NikkiOfTheValley/lumacpu/README.md

# lumacpu
LumaCPU is a custom SBC created for fun/learning
