NikkiOfTheValley/lumacpu/luma_cpu_v4.kicad_pcb

## KiCad design luma_cpu_v4.kicad_pcb (2024-12-23)

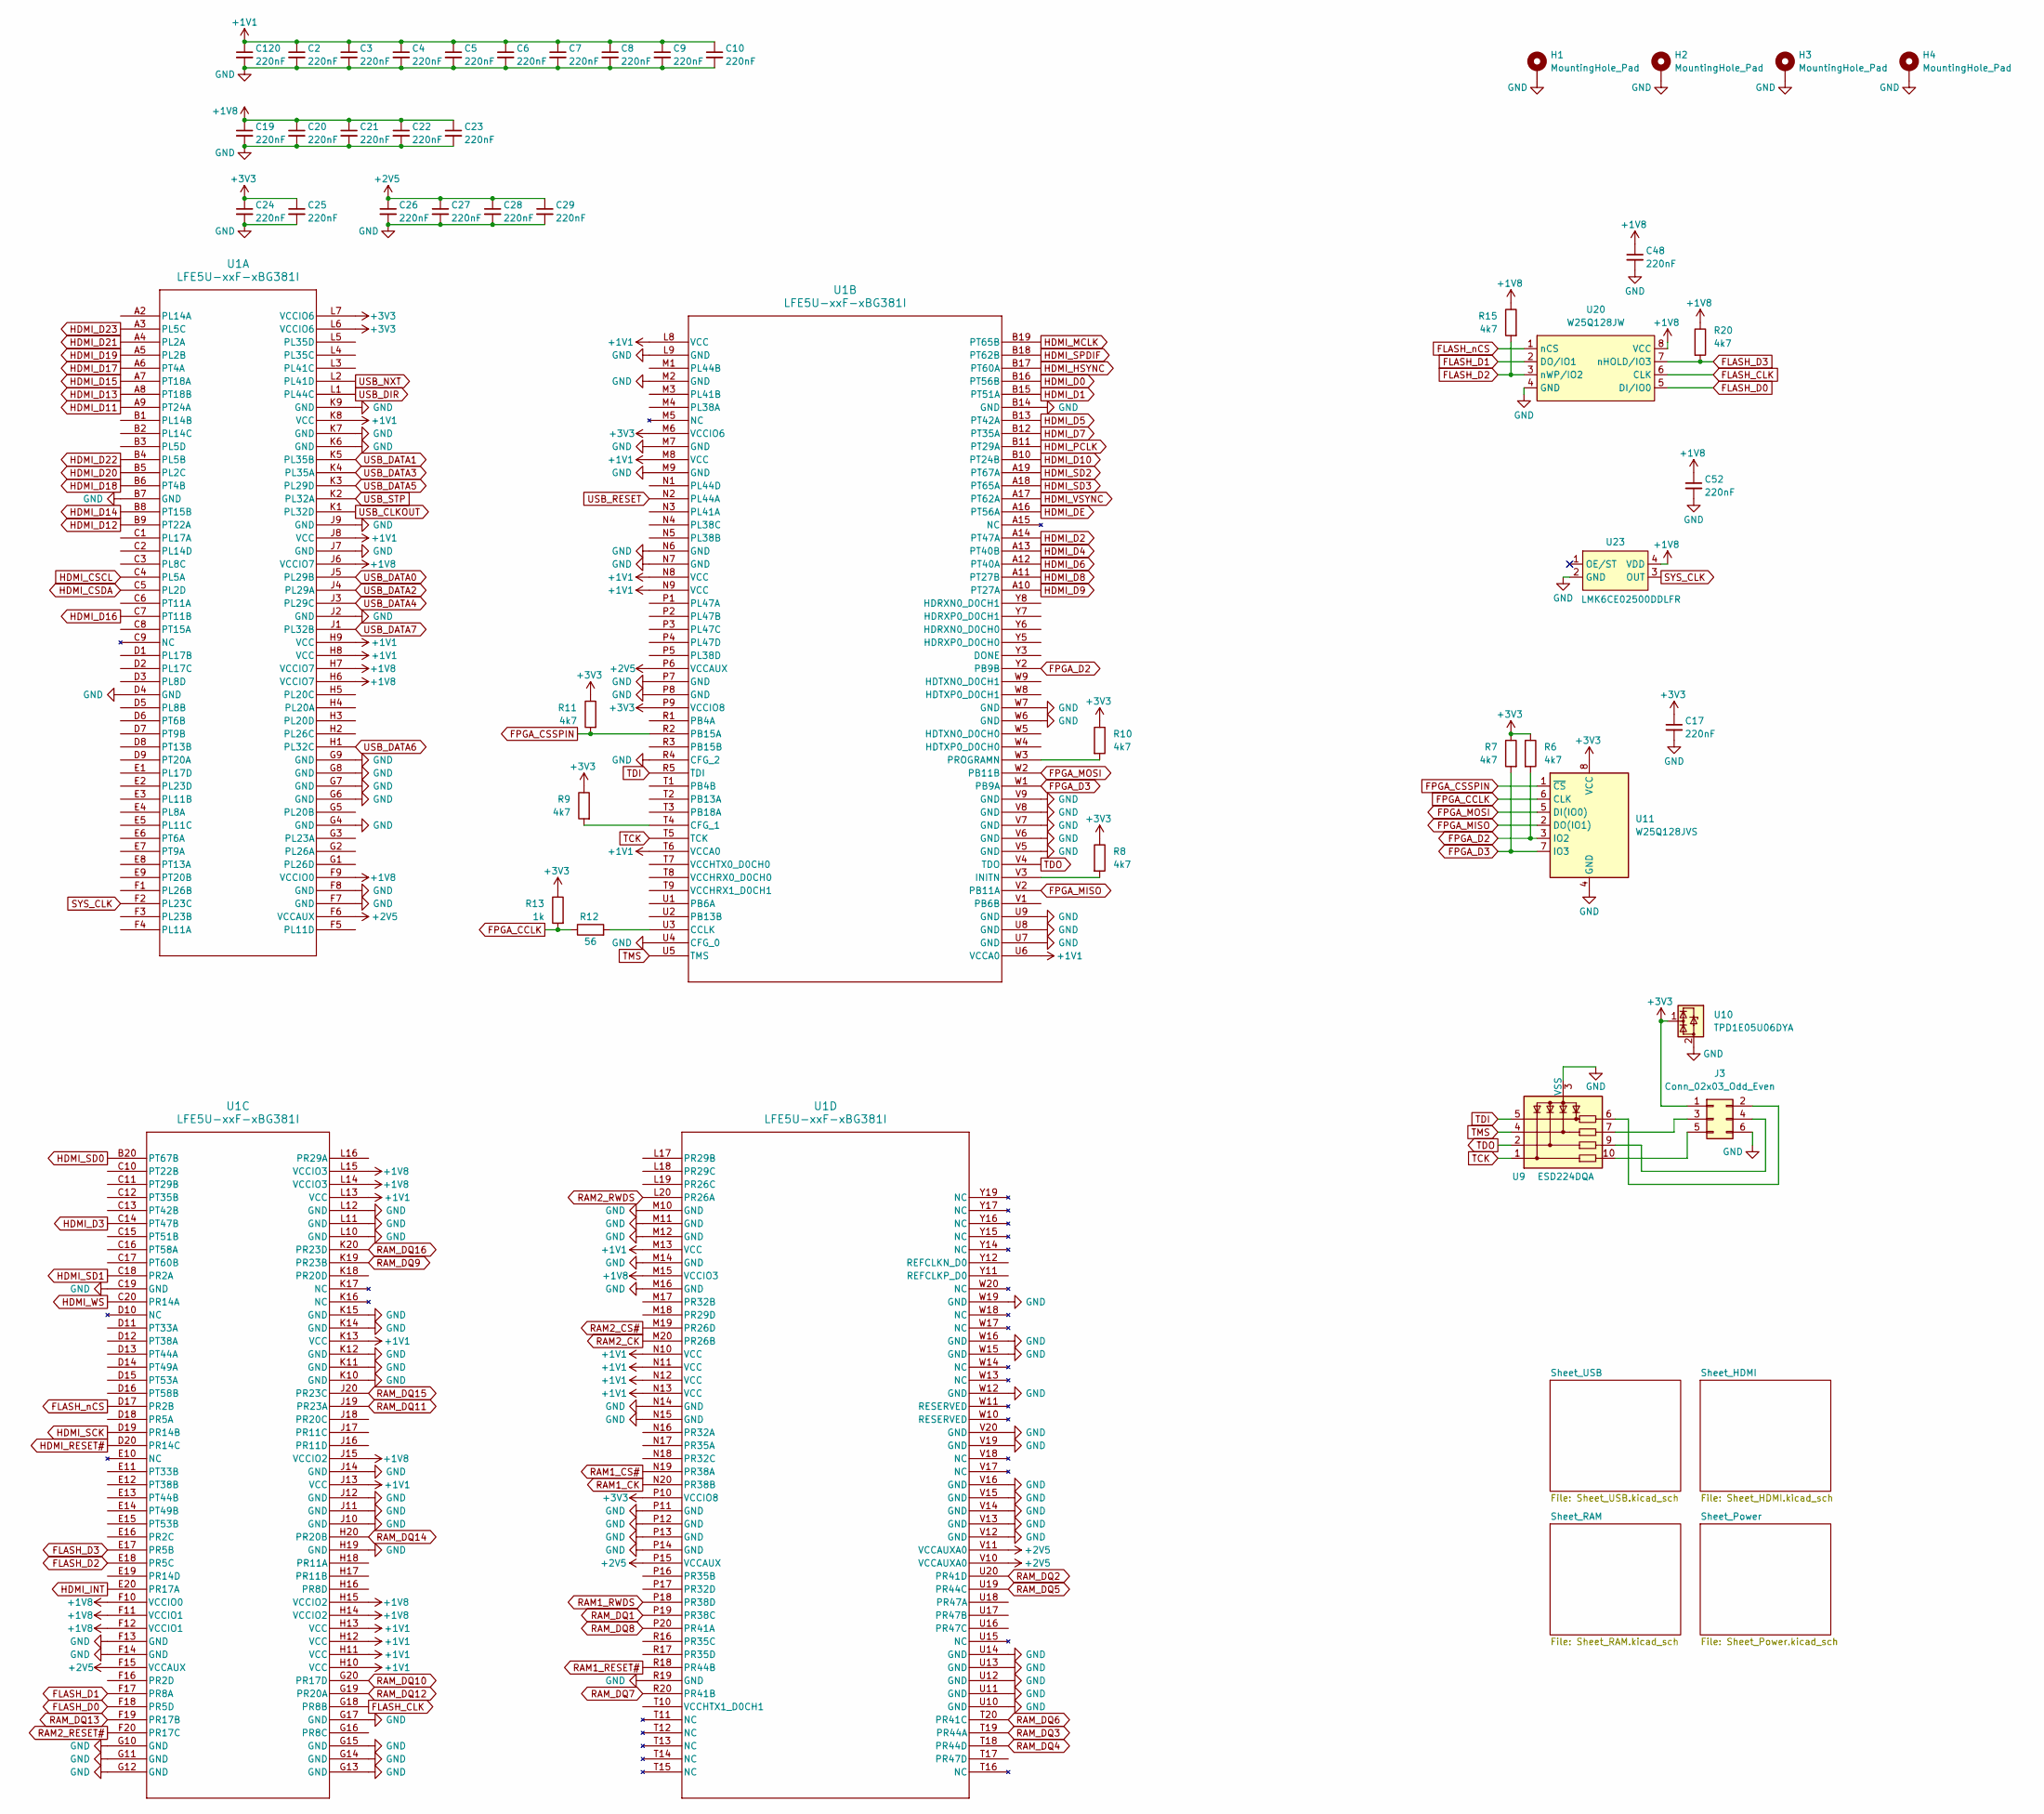
[picture p1: schematic Sheet_FPGA.kicad_sch]

Parts:
C2, C3, C4, C5, C6, C7, C8, C9, C10, C17, C19, C20, C21, C22, C23, C24, C25, C26, C27, C28, C29, C48, C52, C120: 220nF; C_0201_0603Metric_Pad0.64x0.40mm_HandSolder
H1, H2, H3, H4: MountingHole_Pad; MountingHole_1.2mm_M1_Pad
J3: Conn_02x03_Odd_Even; PinHeader_2x03_P2.54mm_Vertical
R6, R7, R8, R9, R10, R11, R15, R20: 4k7; R_0402_1005Metric_Pad0.72x0.64mm_HandSolder
R12: 56; R_0402_1005Metric_Pad0.72x0.64mm_HandSolder
R13: 1k; R_0402_1005Metric_Pad0.72x0.64mm_HandSolder
U1: LFE5U-xxF-xBG381I; CABGA381_LAT
U9: ESD224DQA; Diodes_UDFN-10_1.0x2.5mm_P0.5mm
U10: TPD1E05U06DYA; D_SOD-523
U11: W25Q128JVS; SOIC-8_5.23x5.23mm_P1.27mm
U20: W25Q128JW; SOIC-8W_5.3x5.3mm_P1.27mm
U23: LMK6CE02500DDLFR; VSON-4_2.5x2mm_P1.5mm

Connections:
+1V1: C2.1, C3.1, C4.1, C5.1, C6.1, C7.1, C8.1, C9.1, C10.1, U1.H8 (VCC), U1.H9 (VCC), U1.H10 (VCC), U1.H11 (VCC), U1.H12 (VCC), U1.H13 (VCC), U1.J8 (VCC), U1.J13 (VCC), U1.K8 (VCC), U1.K13 (VCC), U1.L8 (VCC), U1.L13 (VCC), U1.M8 (VCC), U1.M13 (VCC), U1.N8 (VCC), U1.N9 (VCC), U1.N10 (VCC), U1.N11 (VCC), U1.N12 (VCC), U1.N13 (VCC), U1.T6 (VCCA0), U1.U6 (VCCA0); also elsewhere on the board
+1V8: C19.1, C20.1, C21.1, C22.1, C23.1, C48.1, C52.1, R15.1, R20.1, U1.F9 (VCCIO0), U1.F10 (VCCIO0), U1.F11 (VCCIO1), U1.F12 (VCCIO1), U1.H6 (VCCIO7), U1.H7 (VCCIO7), U1.H14 (VCCIO2), U1.H15 (VCCIO2), U1.J6 (VCCIO7), U1.J15 (VCCIO2), U1.L14 (VCCIO3), U1.L15 (VCCIO3), U1.M15 (VCCIO3), U20.8 (VCC), U23.4 (VDD); also elsewhere on the board
+2V5: C26.1, C27.1, C28.1, C29.1, U1.F6 (VCCAUX), U1.F15 (VCCAUX), U1.P6 (VCCAUX), U1.P15 (VCCAUX), U1.V10 (VCCAUXA0), U1.V11 (VCCAUXA0); also elsewhere on the board
+3V3: C17.1, C24.1, C25.1, J3.1, R6.1, R7.1, R8.1, R9.1, R10.1, R11.1, R13.1, U1.L6 (VCCIO6), U1.L7 (VCCIO6), U1.M6 (VCCIO6), U1.P9 (VCCIO8), U1.P10 (VCCIO8), U10.1 (I/O), U11.8 (VCC); also elsewhere on the board
FLASH_CLK: U1.G18 (PR8B), U20.6 (CLK)
FLASH_D0: U1.F18 (PR5D), U20.5 (DI/IO0)
FLASH_D1: U1.F17 (PR8A), U20.2 (DO/IO1)
FLASH_D2: R15.2, U1.E18 (PR5C), U20.3 (nWP/IO2)
FLASH_D3: R20.2, U1.E17 (PR5B), U20.7 (nHOLD/IO3)
FLASH_nCS: U1.D17 (PR2B), U20.1 (nCS)
FPGA_CCLK: R12.1, R13.2, U11.6 (CLK)
FPGA_CSSPIN: R11.2, U1.R2 (PB15A), U11.1 (~CS)
FPGA_D2: R6.2, U1.Y2 (PB9B), U11.3 (IO2)
FPGA_D3: R7.2, U1.W1 (PB9A), U11.7 (IO3)
FPGA_MISO: U1.V2 (PB11A), U11.2 (DO(IO1))
FPGA_MOSI: U1.W2 (PB11B), U11.5 (DI(IO0))
GND: C2.2, C3.2, C4.2, C5.2, C6.2, C7.2, C8.2, C9.2, C10.2, C17.2, C19.2, C20.2, C21.2, C22.2, C23.2, C24.2, C25.2, C26.2, C27.2, C28.2, C29.2, C48.2, C52.2, H1.1, H2.1, H3.1, H4.1, J3.6, U1.B7 (GND), U1.B14 (GND), U1.C19 (GND), U1.D4 (GND), U1.F7 (GND), U1.F8 (GND), U1.F13 (GND), U1.F14 (GND), U1.G4 (GND), U1.G6 (GND), U1.G7 (GND), U1.G8 (GND), U1.G9 (GND), U1.G10 (GND), U1.G11 (GND), U1.G12 (GND), U1.G13 (GND), U1.G14 (GND), U1.G15 (GND), U1.G17 (GND), U1.H19 (GND), U1.J2 (GND), U1.J7 (GND), U1.J9 (GND), U1.J10 (GND), U1.J11 (GND), U1.J12 (GND), U1.J14 (GND), U1.K6 (GND), U1.K7 (GND), U1.K9 (GND), U1.K10 (GND), U1.K11 (GND), U1.K12 (GND), U1.K14 (GND), U1.K15 (GND), U1.L9 (GND), U1.L10 (GND), U1.L11 (GND), U1.L12 (GND), U1.M2 (GND), U1.M7 (GND), U1.M9 (GND), U1.M10 (GND), U1.M11 (GND), U1.M12 (GND), U1.M14 (GND), U1.M16 (GND), U1.N6 (GND), U1.N7 (GND), U1.N14 (GND), U1.N15 (GND), U1.P7 (GND), U1.P8 (GND), U1.P11 (GND), U1.P12 (GND), U1.P13 (GND), U1.P14 (GND), U1.R4 (CFG_2), U1.R19 (GND), U1.U4 (CFG_0), U1.U7 (GND), U1.U8 (GND), U1.U9 (GND), U1.U10 (GND), U1.U11 (GND), U1.U12 (GND), U1.U13 (GND), U1.U14 (GND), U1.V5 (GND), U1.V6 (GND), U1.V7 (GND), U1.V8 (GND), U1.V9 (GND), U1.V12 (GND), U1.V13 (GND), U1.V14 (GND), U1.V15 (GND), U1.V16 (GND), U1.V19 (GND), U1.V20 (GND), U1.W6 (GND), U1.W7 (GND), U1.W12 (GND), U1.W15 (GND), U1.W16 (GND), U1.W19 (GND), U9.3 (VSS), U9.8 (VSS), U10.2 (GND), U11.4 (GND), U20.4 (GND), U23.2 (GND); also elsewhere on the board
HDMI_CSCL: U1.C4 (PL5A); also elsewhere on the board
HDMI_CSDA: U1.C5 (PL2D); also elsewhere on the board
HDMI_D0: U1.B16 (PT56B); also elsewhere on the board
HDMI_D1: U1.B15 (PT51A); also elsewhere on the board
HDMI_D2: U1.A14 (PT47A); also elsewhere on the board
HDMI_D3: U1.C14 (PT47B); also elsewhere on the board
HDMI_D4: U1.A13 (PT40B); also elsewhere on the board
HDMI_D5: U1.B13 (PT42A); also elsewhere on the board
HDMI_D6: U1.A12 (PT40A); also elsewhere on the board
HDMI_D7: U1.B12 (PT35A); also elsewhere on the board
HDMI_D8: U1.A11 (PT27B); also elsewhere on the board
HDMI_D9: U1.A10 (PT27A); also elsewhere on the board
HDMI_D10: U1.B10 (PT24B); also elsewhere on the board
HDMI_D11: U1.A9 (PT24A); also elsewhere on the board
HDMI_D12: U1.B9 (PT22A); also elsewhere on the board
HDMI_D13: U1.A8 (PT18B); also elsewhere on the board
HDMI_D14: U1.B8 (PT15B); also elsewhere on the board
HDMI_D15: U1.A7 (PT18A); also elsewhere on the board
HDMI_D16: U1.C7 (PT11B); also elsewhere on the board
HDMI_D17: U1.A6 (PT4A); also elsewhere on the board
HDMI_D18: U1.B6 (PT4B); also elsewhere on the board
HDMI_D19: U1.A5 (PL2B); also elsewhere on the board
HDMI_D20: U1.B5 (PL2C); also elsewhere on the board
HDMI_D21: U1.A4 (PL2A); also elsewhere on the board
HDMI_D22: U1.B4 (PL5B); also elsewhere on the board
HDMI_D23: U1.A3 (PL5C); also elsewhere on the board
HDMI_DE: U1.A16 (PT56A); also elsewhere on the board
HDMI_HSYNC: U1.B17 (PT60A); also elsewhere on the board
HDMI_INT: U1.E20 (PR17A); also elsewhere on the board
HDMI_MCLK: U1.B19 (PT65B); also elsewhere on the board
HDMI_PCLK: U1.B11 (PT29A); also elsewhere on the board
HDMI_RESET#: U1.D20 (PR14C); also elsewhere on the board
HDMI_SCK: U1.D19 (PR14B); also elsewhere on the board
HDMI_SD0: U1.B20 (PT67B); also elsewhere on the board
HDMI_SD1: U1.C18 (PR2A); also elsewhere on the board
HDMI_SD2: U1.A19 (PT67A); also elsewhere on the board
HDMI_SD3: U1.A18 (PT65A); also elsewhere on the board
HDMI_SPDIF: U1.B18 (PT62B); also elsewhere on the board
HDMI_VSYNC: U1.A17 (PT62A); also elsewhere on the board
HDMI_WS: U1.C20 (PR14A); also elsewhere on the board
unnamed: J3.2, U9.6
unnamed: J3.3, U9.7
unnamed: J3.4, U9.9
unnamed: J3.5, U9.10
unnamed: R12.2, U1.U3 (CCLK)
unnamed: R9.2, U1.T4 (CFG_1)
unnamed: R8.2, U1.V3 (INITN)
unnamed: R10.2, U1.W3 (PROGRAMN)
RAM1_CK: U1.N20 (PR38B); also elsewhere on the board
RAM1_CS#: U1.N19 (PR38A); also elsewhere on the board
RAM1_RESET#: U1.R18 (PR44B); also elsewhere on the board
RAM1_RWDS: U1.P18 (PR38D); also elsewhere on the board
RAM2_CK: U1.M20 (PR26B); also elsewhere on the board
RAM2_CS#: U1.M19 (PR26D); also elsewhere on the board
RAM2_RESET#: U1.F20 (PR17C); also elsewhere on the board
RAM2_RWDS: U1.L20 (PR26A); also elsewhere on the board
RAM_DQ1: U1.P19 (PR38C); also elsewhere on the board
RAM_DQ2: U1.U20 (PR41D); also elsewhere on the board
RAM_DQ3: U1.T19 (PR44A); also elsewhere on the board
RAM_DQ4: U1.T18 (PR44D); also elsewhere on the board
RAM_DQ5: U1.U19 (PR44C); also elsewhere on the board
RAM_DQ6: U1.T20 (PR41C); also elsewhere on the board
RAM_DQ7: U1.R20 (PR41B); also elsewhere on the board
RAM_DQ8: U1.P20 (PR41A); also elsewhere on the board
RAM_DQ9: U1.K19 (PR23B); also elsewhere on the board
RAM_DQ10: U1.G20 (PR17D); also elsewhere on the board
RAM_DQ11: U1.J19 (PR23A); also elsewhere on the board
RAM_DQ12: U1.G19 (PR20A); also elsewhere on the board
RAM_DQ13: U1.F19 (PR17B); also elsewhere on the board
RAM_DQ14: U1.H20 (PR20B); also elsewhere on the board
RAM_DQ15: U1.J20 (PR23C); also elsewhere on the board
RAM_DQ16: U1.K20 (PR23D); also elsewhere on the board
SYS_CLK: U1.F2 (PL23C), U23.3 (OUT)
TCK: U1.T5 (TCK), U9.1
TDI: U1.R5 (TDI), U9.5
TDO: U1.V4 (TDO), U9.2
TMS: U1.U5 (TMS), U9.4
USB_CLKOUT: U1.K1 (PL32D); also elsewhere on the board
USB_DATA0: U1.J5 (PL29B); also elsewhere on the board
USB_DATA1: U1.K5 (PL35B); also elsewhere on the board
USB_DATA2: U1.J4 (PL29A); also elsewhere on the board
USB_DATA3: U1.K4 (PL35A); also elsewhere on the board
USB_DATA4: U1.J3 (PL29C); also elsewhere on the board
USB_DATA5: U1.K3 (PL29D); also elsewhere on the board
USB_DATA6: U1.H1 (PL32C); also elsewhere on the board
USB_DATA7: U1.J1 (PL32B); also elsewhere on the board
USB_DIR: U1.L1 (PL44C); also elsewhere on the board
USB_NXT: U1.L2 (PL41D); also elsewhere on the board
USB_RESET: U1.N2 (PL44A); also elsewhere on the board
USB_STP: U1.K2 (PL32A); also elsewhere on the board

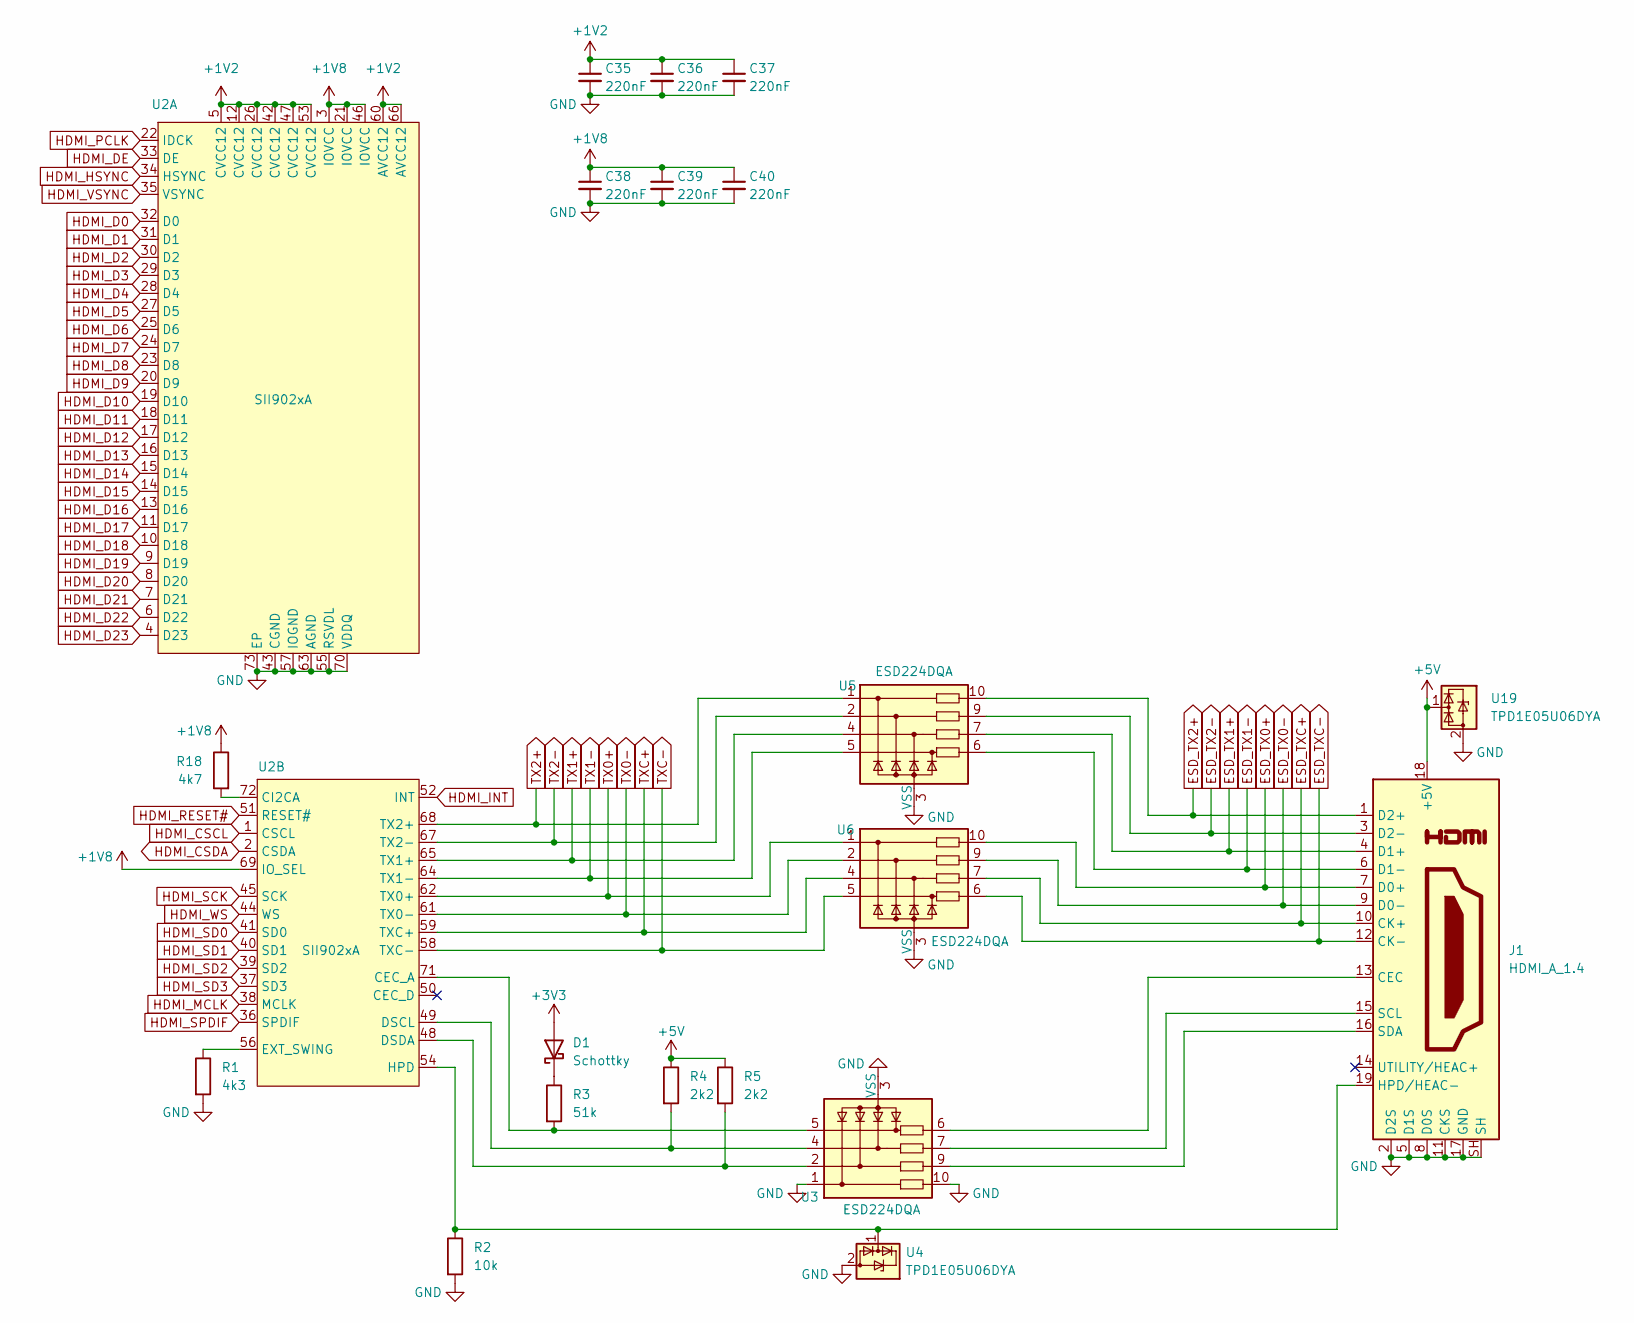
[picture p2: schematic Sheet_HDMI.kicad_sch]

Parts:
C35, C36, C37, C38, C39, C40: 220nF; C_0201_0603Metric_Pad0.64x0.40mm_HandSolder
D1: Schottky; D_SOD-523
J1: HDMI_A_1.4; HDMI_A_Amphenol_10029449-x01xLF_Horizontal
R1: 4k3; R_0402_1005Metric_Pad0.72x0.64mm_HandSolder
R2: 10k; R_0402_1005Metric_Pad0.72x0.64mm_HandSolder
R3: 51k; R_0402_1005Metric_Pad0.72x0.64mm_HandSolder
R4, R5: 2k2; R_0402_1005Metric_Pad0.72x0.64mm_HandSolder
R18: 4k7; R_0402_1005Metric_Pad0.72x0.64mm_HandSolder
U2: SII902xA; QFN-72-1EP_10x10mm_P0.5mm_EP6x6mm
U3, U5, U6: ESD224DQA; Diodes_UDFN-10_1.0x2.5mm_P0.5mm
U4, U19: TPD1E05U06DYA; D_SOD-523

Connections:
+1V2: C35.1, C36.1, C37.1, U2.5 (CVCC12), U2.12 (CVCC12), U2.26 (CVCC12), U2.42 (CVCC12), U2.47 (CVCC12), U2.53 (CVCC12), U2.60 (AVCC12), U2.66 (AVCC12); also elsewhere on the board
+1V8: C38.1, C39.1, C40.1, R18.1, U2.3 (IOVCC), U2.21 (IOVCC), U2.46 (IOVCC), U2.69 (IO_SEL); also elsewhere on the board
+3V3: D1.2 (A); also elsewhere on the board
+5V: J1.18 (+5V), R4.1, R5.1, U19.1 (I/O); also elsewhere on the board
ESD_TX0+: J1.7 (D0+), U6.10
ESD_TX0-: J1.9 (D0-), U6.9
ESD_TX1+: J1.4 (D1+), U5.7
ESD_TX1-: J1.6 (D1-), U5.6
ESD_TX2+: J1.1 (D2+), U5.10
ESD_TX2-: J1.3 (D2-), U5.9
ESD_TXC+: J1.10 (CK+), U6.7
ESD_TXC-: J1.12 (CK-), U6.6
GND: C35.2, C36.2, C37.2, C38.2, C39.2, C40.2, J1.2 (D2S), J1.5 (D1S), J1.8 (D0S), J1.11 (CKS), J1.17 (GND), J1.SH, R1.2, R2.2, U2.43 (CGND), U2.55 (RSVDL), U2.57 (IOGND), U2.63 (AGND), U2.70 (VDDQ), U2.73 (EP), U3.1, U3.3 (VSS), U3.8 (VSS), U3.10, U4.2 (GND), U5.3 (VSS), U5.8 (VSS), U6.3 (VSS), U6.8 (VSS), U19.2 (GND); also elsewhere on the board
HDMI_CSCL: U2.1 (CSCL); also elsewhere on the board
HDMI_CSDA: U2.2 (CSDA); also elsewhere on the board
HDMI_D0: U2.32 (D0); also elsewhere on the board
HDMI_D1: U2.31 (D1); also elsewhere on the board
HDMI_D2: U2.30 (D2); also elsewhere on the board
HDMI_D3: U2.29 (D3); also elsewhere on the board
HDMI_D4: U2.28 (D4); also elsewhere on the board
HDMI_D5: U2.27 (D5); also elsewhere on the board
HDMI_D6: U2.25 (D6); also elsewhere on the board
HDMI_D7: U2.24 (D7); also elsewhere on the board
HDMI_D8: U2.23 (D8); also elsewhere on the board
HDMI_D9: U2.20 (D9); also elsewhere on the board
HDMI_D10: U2.19 (D10); also elsewhere on the board
HDMI_D11: U2.18 (D11); also elsewhere on the board
HDMI_D12: U2.17 (D12); also elsewhere on the board
HDMI_D13: U2.16 (D13); also elsewhere on the board
HDMI_D14: U2.15 (D14); also elsewhere on the board
HDMI_D15: U2.14 (D15); also elsewhere on the board
HDMI_D16: U2.13 (D16); also elsewhere on the board
HDMI_D17: U2.11 (D17); also elsewhere on the board
HDMI_D18: U2.10 (D18); also elsewhere on the board
HDMI_D19: U2.9 (D19); also elsewhere on the board
HDMI_D20: U2.8 (D20); also elsewhere on the board
HDMI_D21: U2.7 (D21); also elsewhere on the board
HDMI_D22: U2.6 (D22); also elsewhere on the board
HDMI_D23: U2.4 (D23); also elsewhere on the board
HDMI_DE: U2.33 (DE); also elsewhere on the board
HDMI_HSYNC: U2.34 (HSYNC); also elsewhere on the board
HDMI_INT: U2.52 (INT); also elsewhere on the board
HDMI_MCLK: U2.38 (MCLK); also elsewhere on the board
HDMI_PCLK: U2.22 (IDCK); also elsewhere on the board
HDMI_RESET#: U2.51 (RESET#); also elsewhere on the board
HDMI_SCK: U2.45 (SCK); also elsewhere on the board
HDMI_SD0: U2.41 (SD0); also elsewhere on the board
HDMI_SD1: U2.40 (SD1); also elsewhere on the board
HDMI_SD2: U2.39 (SD2); also elsewhere on the board
HDMI_SD3: U2.37 (SD3); also elsewhere on the board
HDMI_SPDIF: U2.36 (SPDIF); also elsewhere on the board
HDMI_VSYNC: U2.35 (VSYNC); also elsewhere on the board
HDMI_WS: U2.44 (WS); also elsewhere on the board
unnamed: D1.1 (K), R3.1
unnamed: J1.13 (CEC), U3.6
unnamed: J1.19 (HPD/HEAC-), R2.1, U2.54 (HPD), U4.1 (I/O)
unnamed: J1.15 (SCL), U3.7
unnamed: J1.16 (SDA), U3.9
unnamed: R3.2, U2.71 (CEC_A), U3.5
unnamed: R18.2, U2.72 (CI2CA)
unnamed: R4.2, U2.49 (DSCL), U3.4
unnamed: R5.2, U2.48 (DSDA), U3.2
unnamed: R1.1, U2.56 (EXT_SWING)
TX0+: U2.62 (TX0+), U6.1
TX0-: U2.61 (TX0-), U6.2
TX1+: U2.65 (TX1+), U5.4
TX1-: U2.64 (TX1-), U5.5
TX2+: U2.68 (TX2+), U5.1
TX2-: U2.67 (TX2-), U5.2
TXC+: U2.59 (TXC+), U6.4
TXC-: U2.58 (TXC-), U6.5

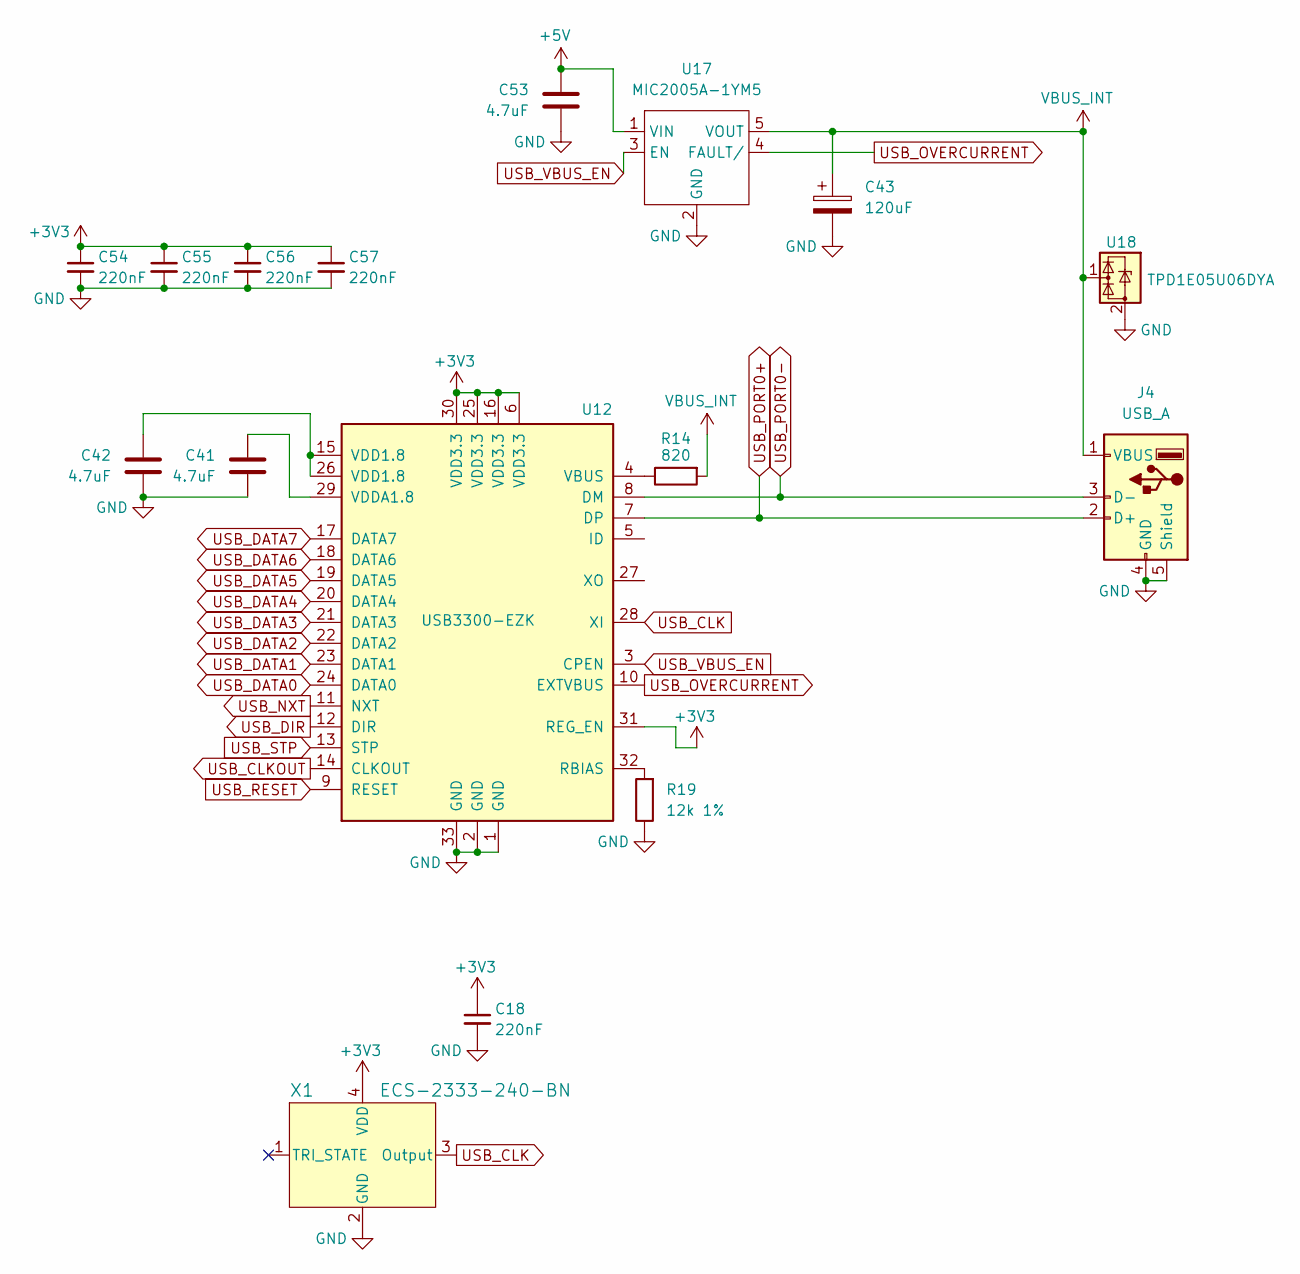
[picture p3: schematic Sheet_USB.kicad_sch]

Parts:
C18, C54, C55, C56, C57: 220nF; C_0201_0603Metric_Pad0.64x0.40mm_HandSolder
C41, C42, C53: 4.7uF; C_0402_1005Metric_Pad0.74x0.62mm_HandSolder
C43: 120uF; CP_Elec_6.3x5.8
J4: USB_A; USB_A_Molex_67643_Horizontal
R14: 820; R_0402_1005Metric_Pad0.72x0.64mm_HandSolder
R19: 12k 1%; R_0402_1005Metric_Pad0.72x0.64mm_HandSolder
U12: USB3300-EZK; QFN-32-1EP_5x5mm_P0.5mm_EP3.45x3.45mm
U17: MIC2005A-1YM5; SOT-23-5
U18: TPD1E05U06DYA; D_SOD-523
X1: ECS-2333-240-BN; ECS-2333_ECS

Connections:
+3V3: C18.1, C54.1, C55.1, C56.1, C57.1, U12.6 (VDD3.3), U12.16 (VDD3.3), U12.25 (VDD3.3), U12.30 (VDD3.3), U12.31 (REG_EN), X1.4 (VDD); also elsewhere on the board
+5V: C53.1, U17.1 (VIN); also elsewhere on the board
GND: C18.2, C41.2, C42.2, C43.2, C53.2, C54.2, C55.2, C56.2, C57.2, J4.4 (GND), J4.5 (Shield), R19.1, U12.1 (GND), U12.2 (GND), U12.33 (GND), U17.2 (GND), U18.2 (GND), X1.2 (GND); also elsewhere on the board
unnamed: C42.1, U12.15 (VDD1.8), U12.26 (VDD1.8)
unnamed: R19.2, U12.32 (RBIAS)
unnamed: R14.1, U12.4 (VBUS)
unnamed: C41.1, U12.29 (VDDA1.8)
USB_CLK: U12.28 (XI), X1.3 (Output)
USB_CLKOUT: U12.14 (CLKOUT); also elsewhere on the board
USB_DATA0: U12.24 (DATA0); also elsewhere on the board
USB_DATA1: U12.23 (DATA1); also elsewhere on the board
USB_DATA2: U12.22 (DATA2); also elsewhere on the board
USB_DATA3: U12.21 (DATA3); also elsewhere on the board
USB_DATA4: U12.20 (DATA4); also elsewhere on the board
USB_DATA5: U12.19 (DATA5); also elsewhere on the board
USB_DATA6: U12.18 (DATA6); also elsewhere on the board
USB_DATA7: U12.17 (DATA7); also elsewhere on the board
USB_DIR: U12.12 (DIR); also elsewhere on the board
USB_NXT: U12.11 (NXT); also elsewhere on the board
USB_OVERCURRENT: U12.10 (EXTVBUS), U17.4 (FAULT/)
USB_PORT0+: J4.2 (D+), U12.7 (DP)
USB_PORT0-: J4.3 (D-), U12.8 (DM)
USB_RESET: U12.9 (RESET); also elsewhere on the board
USB_STP: U12.13 (STP); also elsewhere on the board
USB_VBUS_EN: U12.3 (CPEN), U17.3 (EN)
VBUS_INT: C43.1, J4.1 (VBUS), R14.2, U17.5 (VOUT), U18.1 (I/O)

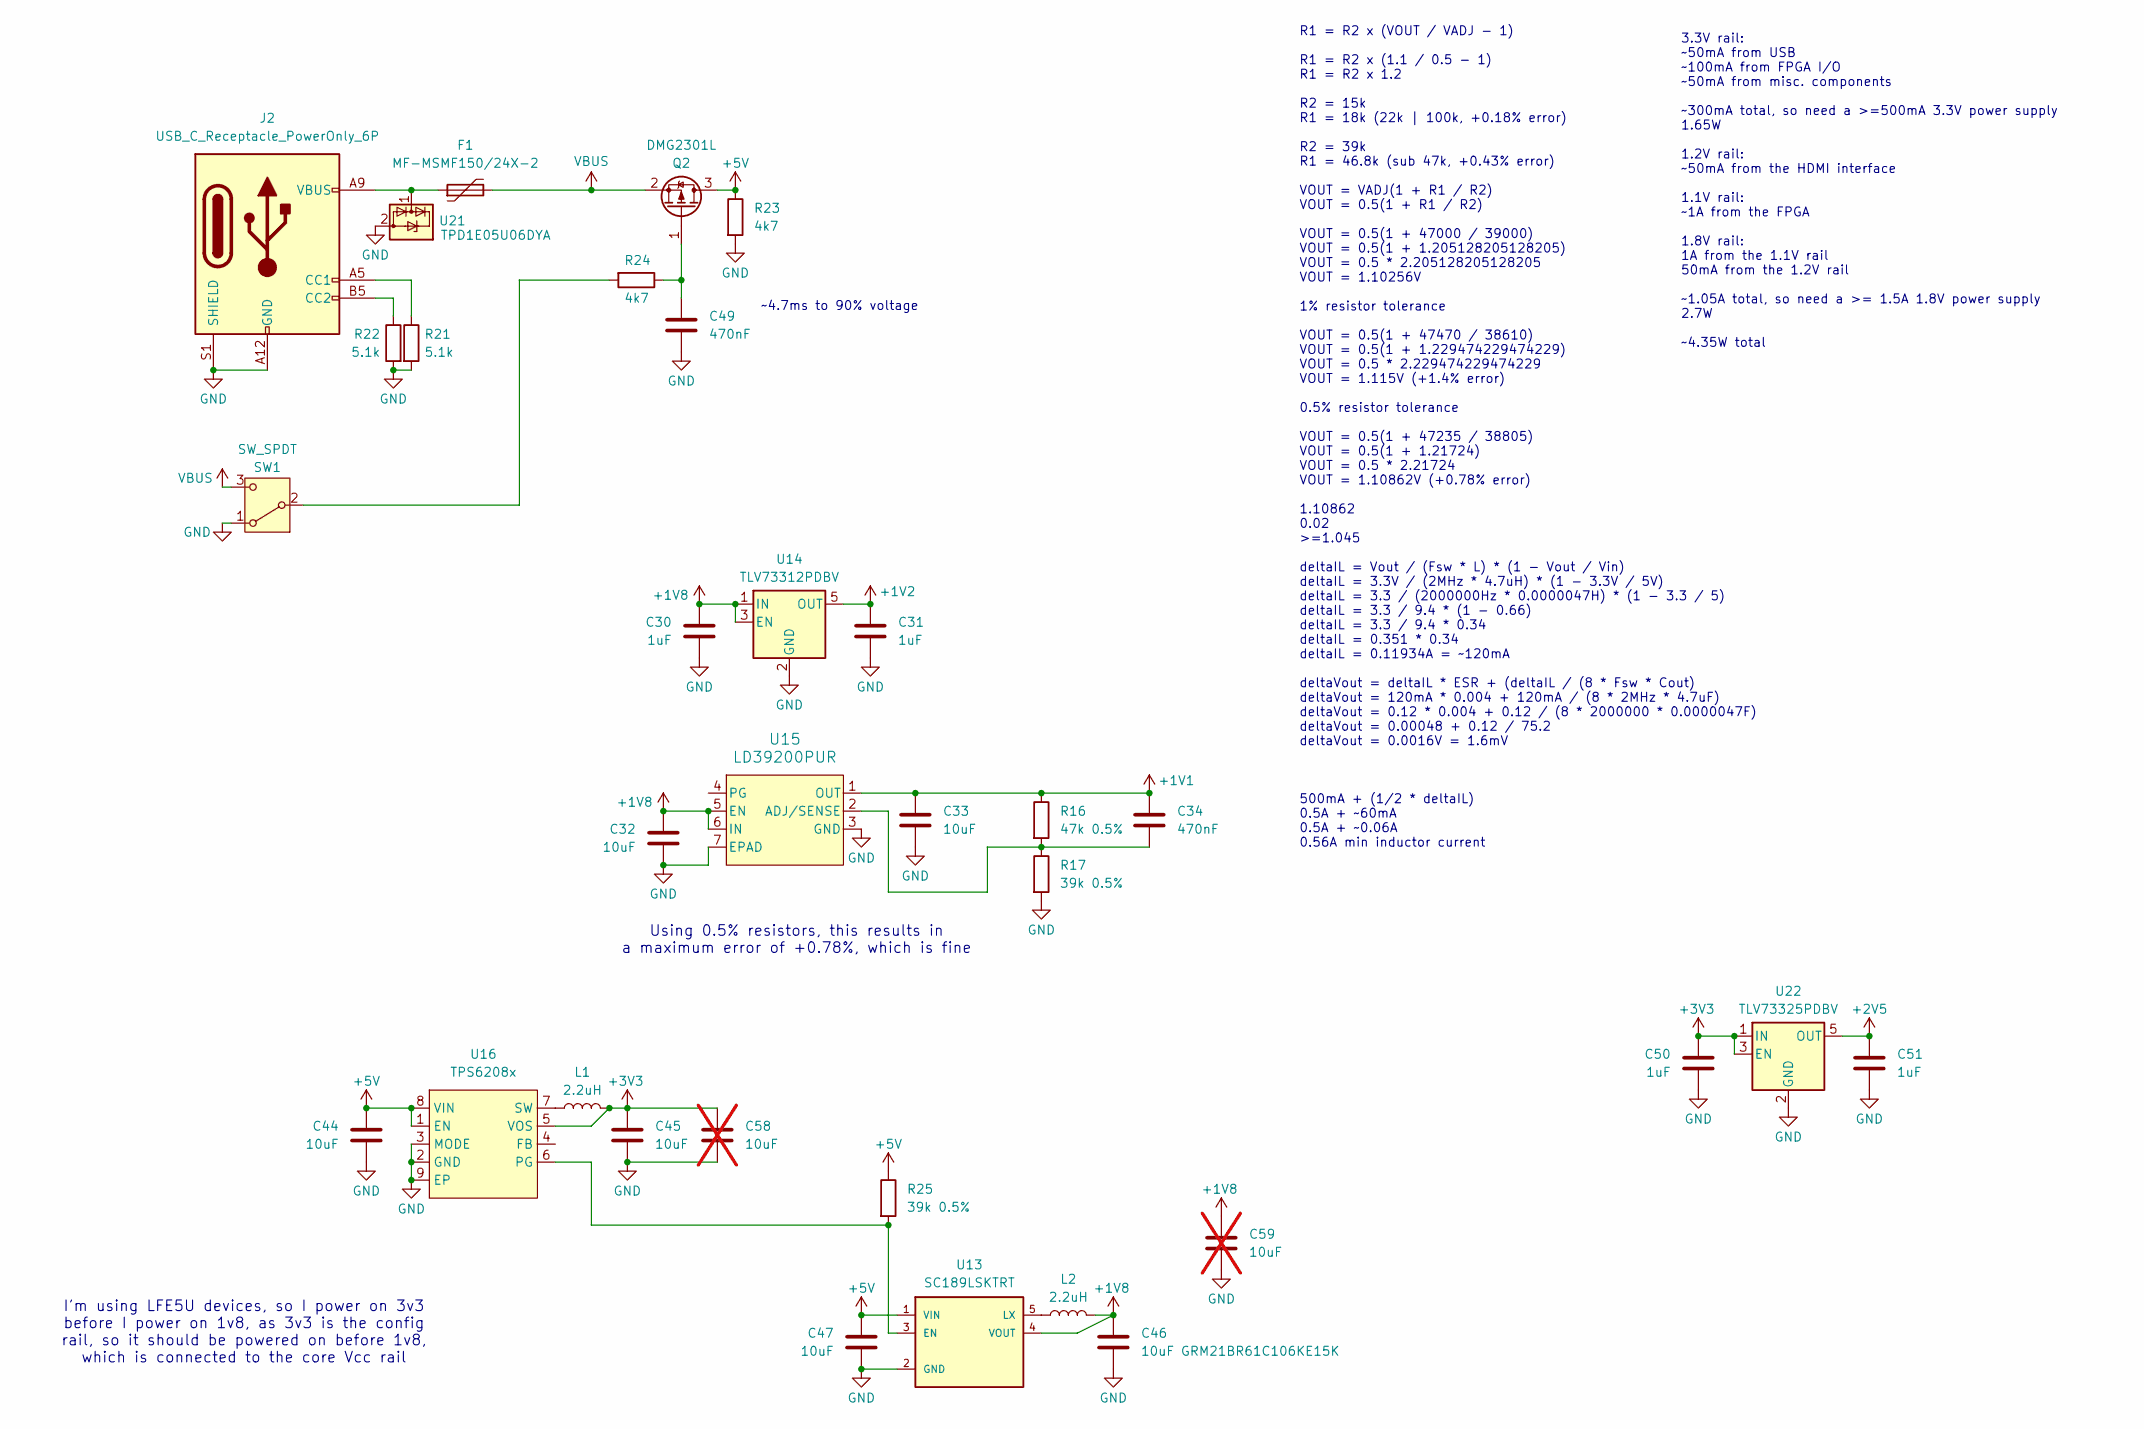
[picture p4: schematic Sheet_Power.kicad_sch]

Parts:
C30, C31, C50, C51: 1uF; C_0402_1005Metric_Pad0.74x0.62mm_HandSolder
C32, C33, C44, C45, C47: 10uF; C_0603_1608Metric_Pad1.08x0.95mm_HandSolder
C34, C49: 470nF; C_0402_1005Metric_Pad0.74x0.62mm_HandSolder
C46: 10uF GRM21BR61C106KE15K; C_0805_2012Metric_Pad1.18x1.45mm_HandSolder
C58, C59: 10uF; C_0603_1608Metric_Pad1.08x0.95mm_HandSolder; not fitted
F1: MF-MSMF150/24X-2; Fuse_1812_4532Metric_Pad1.30x3.40mm_HandSolder
J2: USB_C_Receptacle_PowerOnly_6P; USB_C_Receptacle_GCT_USB4125-xx-x_6P_TopMnt_Horizontal
L1, L2: 2.2uH; IND_TAIYO_NRS4018_TAY
Q2: DMG2301L; SOT-23
R16: 47k 0.5%; R_0402_1005Metric_Pad0.72x0.64mm_HandSolder
R17, R25: 39k 0.5%; R_0402_1005Metric_Pad0.72x0.64mm_HandSolder
R21, R22: 5.1k; R_0402_1005Metric_Pad0.72x0.64mm_HandSolder
R23, R24: 4k7; R_0402_1005Metric_Pad0.72x0.64mm_HandSolder
SW1: SW_SPDT; PinSocket_1x03_P2.54mm_Vertical
U13: SC189LSKTRT; SOT95P280X145-5N
U14: TLV73312PDBV; SOT-23-5
U15: LD39200PUR; DFN6_3P1X3P1X0P95_STM
U16: TPS6208x; WSON-8-1EP_2x2mm_P0.5mm_EP0.9x1.6mm
U21: TPD1E05U06DYA; D_SOD-523
U22: TLV73325PDBV; SOT-23-5

Connections:
+1V1: C33.1, C34.1, R16.1, U15.1 (OUT); also elsewhere on the board
+1V2: C31.1, U14.5 (OUT); also elsewhere on the board
+1V8: C30.1, C32.1, C46.1, C59.1, L2.2, U13.4 (VOUT), U14.1 (IN), U14.3 (EN), U15.5 (EN), U15.6 (IN); also elsewhere on the board
+2V5: C51.1, U22.5 (OUT); also elsewhere on the board
+3V3: C45.1, C50.1, C58.1, L1.2, U16.5 (VOS), U22.1 (IN), U22.3 (EN); also elsewhere on the board
+5V: C44.1, C47.1, Q2.3 (D), R23.1, R25.1, U13.1 (VIN), U16.1 (EN), U16.8 (VIN); also elsewhere on the board
GND: C30.2, C31.2, C32.2, C33.2, C44.2, C45.2, C46.2, C47.2, C49.2, C50.2, C51.2, C58.2, C59.2, J2.A12 (GND), J2.B12 (GND), J2.S1 (SHIELD), R17.2, R21.2, R22.2, R23.2, SW1.1 (A), U13.2 (GND), U14.2 (GND), U15.3 (GND), U15.7 (EPAD), U16.2 (GND), U16.3 (MODE), U16.9 (EP), U21.2 (GND), U22.2 (GND); also elsewhere on the board
unnamed: J2.A5 (CC1), R21.1
unnamed: J2.B5 (CC2), R22.1
unnamed: C49.1, Q2.1 (G), R24.1
unnamed: R24.2, SW1.2 (B)
unnamed: R25.2, U13.3 (EN), U16.6 (PG)
unnamed: L2.1, U13.5 (LX)
unnamed: C34.2, R16.2, R17.1, U15.2 (ADJ/SENSE)
unnamed: L1.1, U16.7 (SW)
unnamed: F1.1, J2.A9 (VBUS), J2.B9 (VBUS), U21.1 (I/O)
VBUS: F1.2, Q2.2 (S), SW1.3 (C)

Notes on the sheet:
3.3V rail: ~50mA from USB ~100mA from FPGA I/O ~50mA from misc. components ~300mA total, so need a >=500mA 3.3V power supply 1.65W 1.2V rail: ~50mA from the HDMI interface 1.1V rail: ~1A from the FPGA 1.8V rail: 1A from the 1.1V rail 50mA from the 1.2V rail ~1.05A total, so need a >= 1.5A 1.8V powe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
~4.7ms to 90% voltage
Using 0.5% resistors, this results in a maximum error of +0.78%, which is fine
I'm using LFE5U devices, so I power on 3v3 before I power on 1v8, as 3v3 is the config rail, so it should be powered on before 1v8, which is connected to the core Vcc rail
R1 = R2 x (VOUT / VADJ - 1) R1 = R2 x (1.1 / 0.5 - 1) R1 = R2 x 1.2 R2 = 15k R1 = 18k (22k | 100k, +0.18% error) R2 = 39k R1 = 46.8k (sub 47k, +0.43% error) VOUT = VADJ(1 + R1 / R2) VOUT = 0.5(1 + R1 / R2) VOUT = 0.5(1 + 47000 / 39000) VOUT = 0.5(1 + 1.205128205128205) VOUT = 0.5 * 2.20512820512820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
