NikkiOfTheValley/lumacpu/luma_cpu_v4.kicad_pcb

## KiCad design luma_cpu_v4.kicad_pcb (continued)

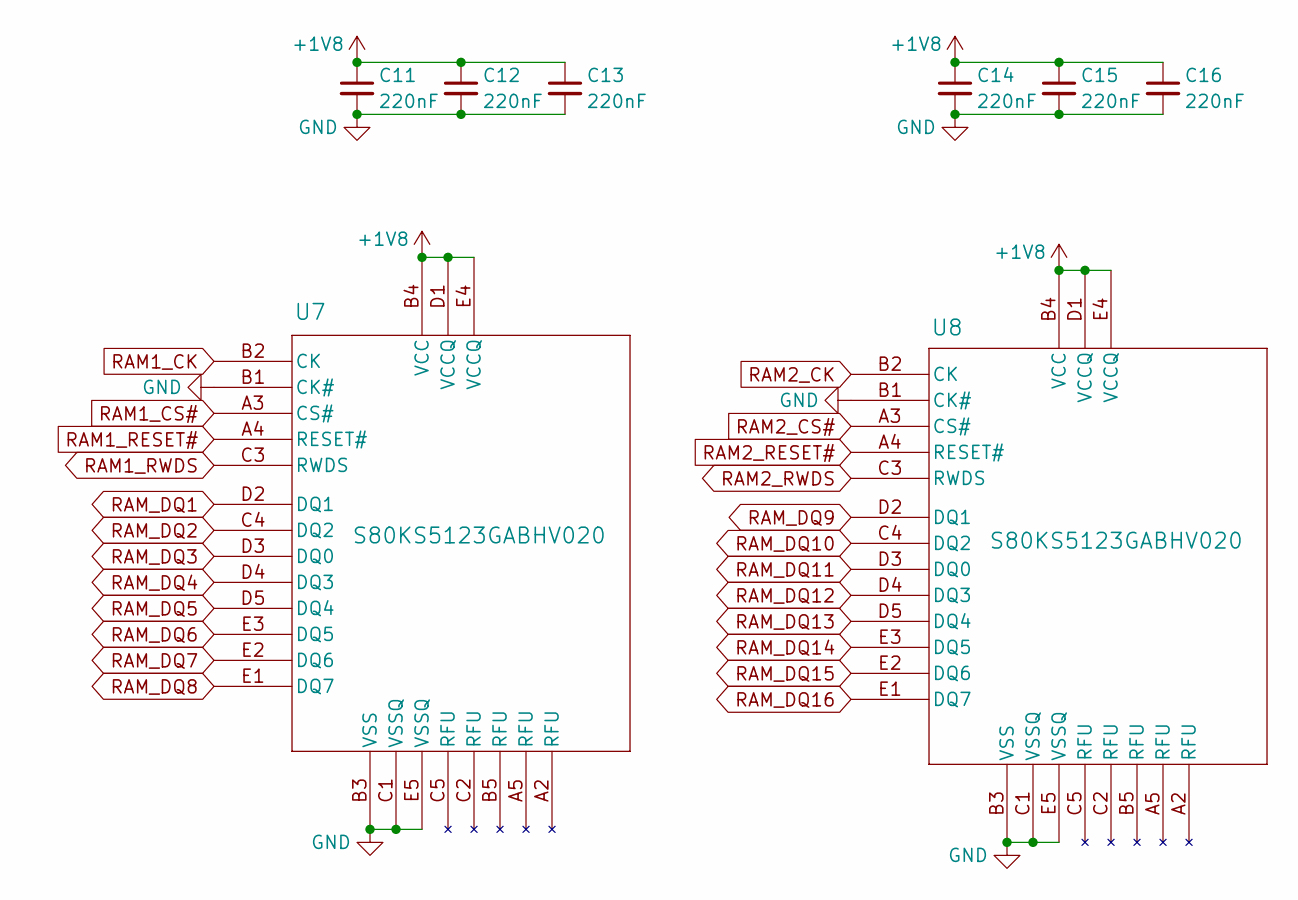
[picture p5: schematic Sheet_RAM.kicad_sch]

Parts:
C11, C12, C13, C14, C15, C16: 220nF; C_0201_0603Metric_Pad0.64x0.40mm_HandSolder
U7, U8: S80KS5123GABHV020; PG-BGA-24-801

Connections:
+1V8: C11.1, C12.1, C13.1, C14.1, C15.1, C16.1, U7.B4 (VCC), U7.D1 (VCCQ), U7.E4 (VCCQ), U8.B4 (VCC), U8.D1 (VCCQ), U8.E4 (VCCQ); also elsewhere on the board
GND: C11.2, C12.2, C13.2, C14.2, C15.2, C16.2, U7.B1 (CK#), U7.B3 (VSS), U7.C1 (VSSQ), U7.E5 (VSSQ), U8.B1 (CK#), U8.B3 (VSS), U8.C1 (VSSQ), U8.E5 (VSSQ); also elsewhere on the board
RAM1_CK: U7.B2 (CK); also elsewhere on the board
RAM1_CS#: U7.A3 (CS#); also elsewhere on the board
RAM1_RESET#: U7.A4 (RESET#); also elsewhere on the board
RAM1_RWDS: U7.C3 (RWDS); also elsewhere on the board
RAM2_CK: U8.B2 (CK); also elsewhere on the board
RAM2_CS#: U8.A3 (CS#); also elsewhere on the board
RAM2_RESET#: U8.A4 (RESET#); also elsewhere on the board
RAM2_RWDS: U8.C3 (RWDS); also elsewhere on the board
RAM_DQ1: U7.D2 (DQ1); also elsewhere on the board
RAM_DQ2: U7.C4 (DQ2); also elsewhere on the board
RAM_DQ3: U7.D3 (DQ0); also elsewhere on the board
RAM_DQ4: U7.D4 (DQ3); also elsewhere on the board
RAM_DQ5: U7.D5 (DQ4); also elsewhere on the board
RAM_DQ6: U7.E3 (DQ5); also elsewhere on the board
RAM_DQ7: U7.E2 (DQ6); also elsewhere on the board
RAM_DQ8: U7.E1 (DQ7); also elsewhere on the board
RAM_DQ9: U8.D2 (DQ1); also elsewhere on the board
RAM_DQ10: U8.C4 (DQ2); also elsewhere on the board
RAM_DQ11: U8.D3 (DQ0); also elsewhere on the board
RAM_DQ12: U8.D4 (DQ3); also elsewhere on the board
RAM_DQ13: U8.D5 (DQ4); also elsewhere on the board
RAM_DQ14: U8.E3 (DQ5); also elsewhere on the board
RAM_DQ15: U8.E2 (DQ6); also elsewhere on the board
RAM_DQ16: U8.E1 (DQ7); also elsewhere on the board

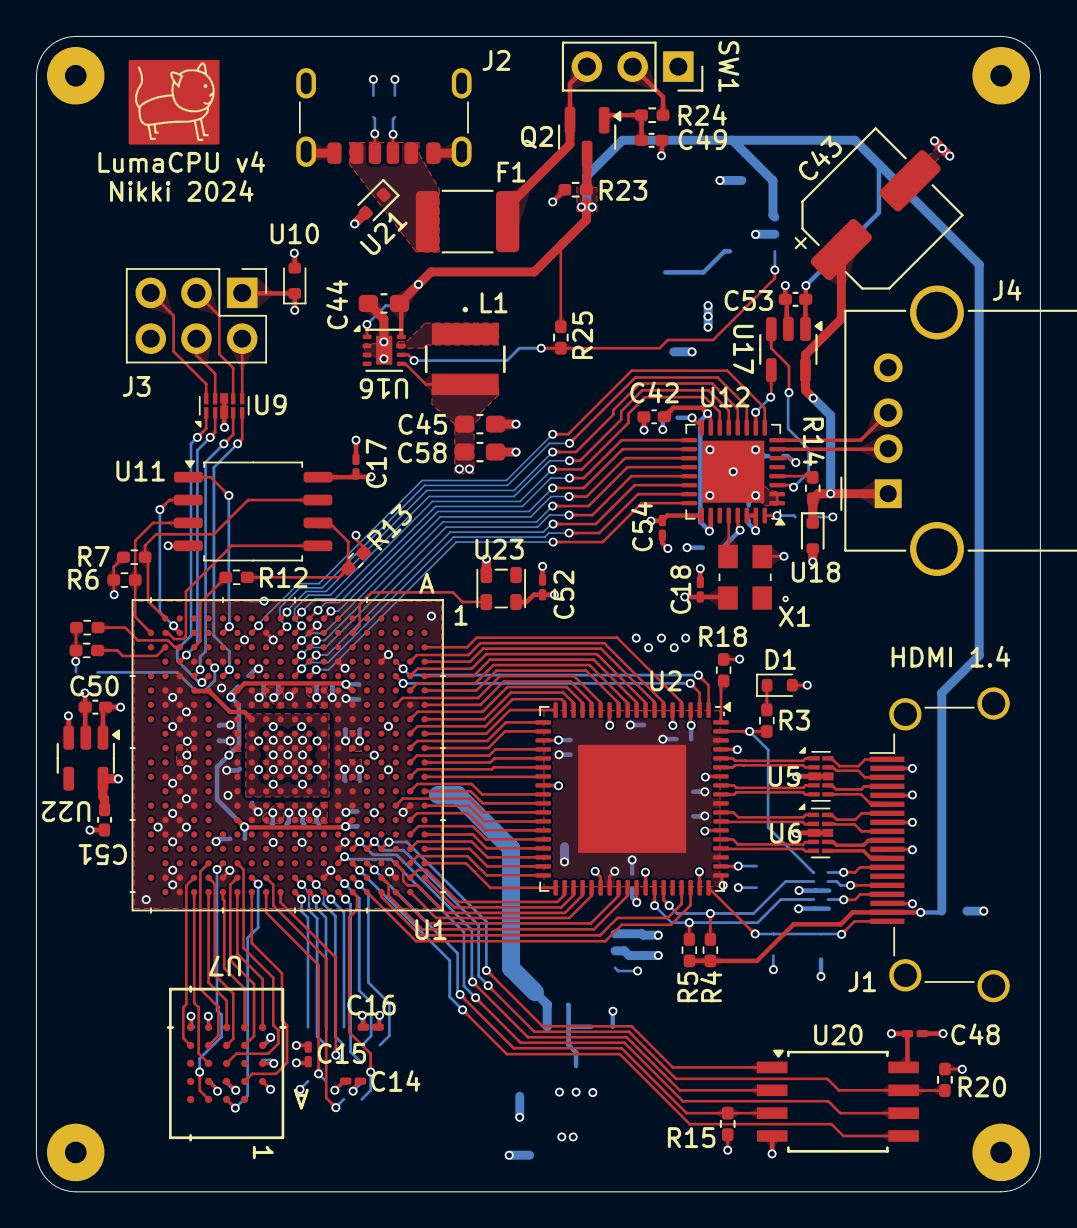
[picture p6: board luma_cpu_v4.kicad_pcb from above]

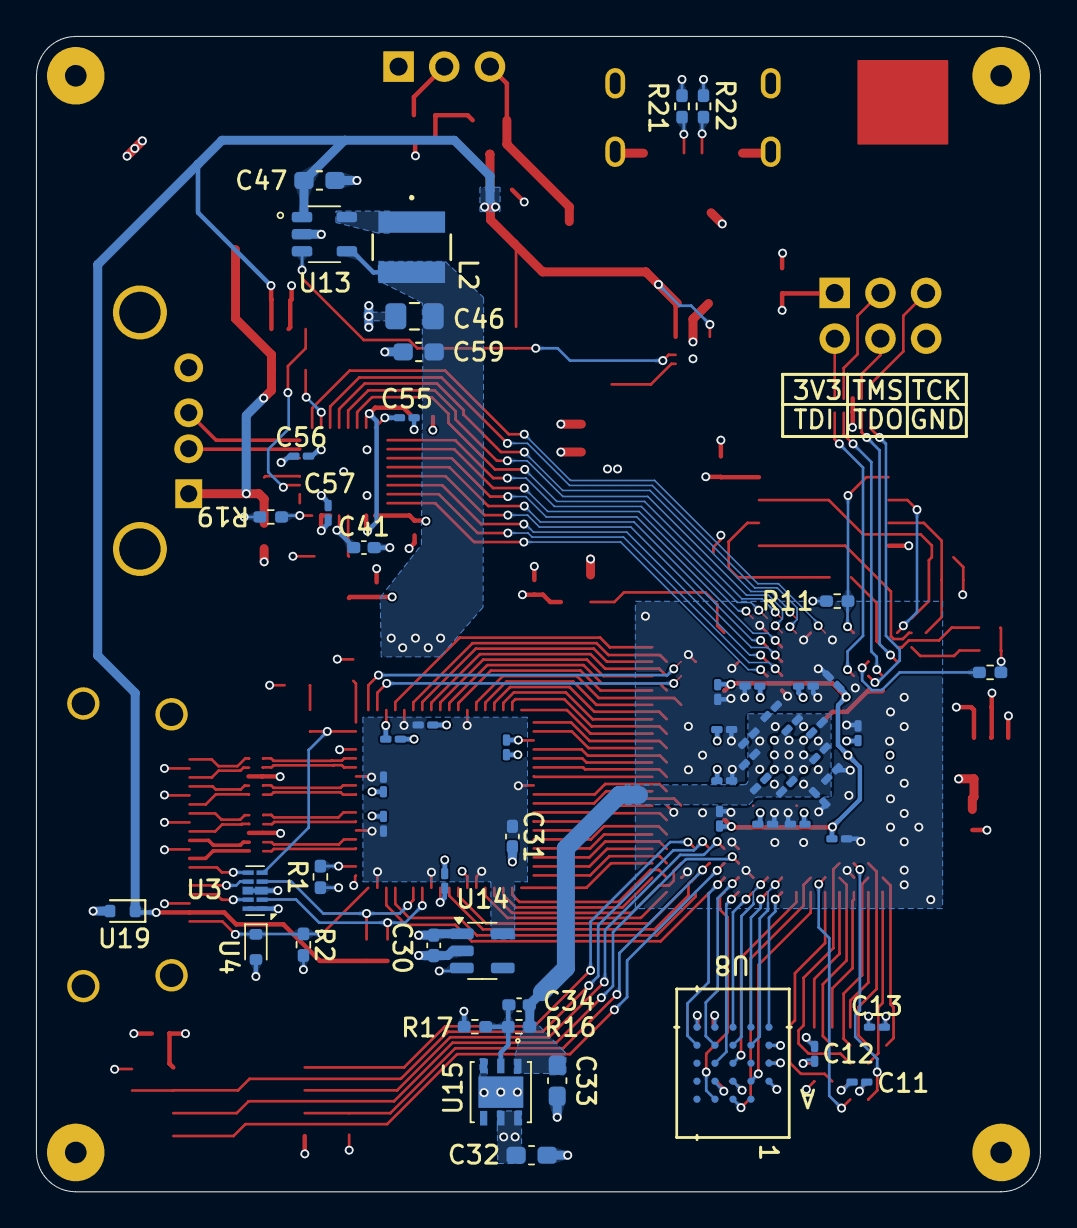
[picture p7: board luma_cpu_v4.kicad_pcb from below]

Board: 4 copper layers, 55.8 x 64.2 mm, 122 parts (59 on the bottom side), 155 nets.

Other parts of the board:
C1: 220nF; C_0201_0603Metric_Pad0.64x0.40mm_HandSolder

Their connections:
+1V1: C1.1; also elsewhere on the board
GND: C1.2; also elsewhere on the board
