NikkiOfTheValley/lumacpu/(commit log)

2024-12-22 Added KiCAD project files
    [Sheet_FPGA.kicad_sch, Sheet_HDMI.kicad_sch, Sheet_Power.kicad_sch, Sheet_RAM.kicad_sch, Sheet_USB.kicad_sch, bom.csv, luma_cpu_v4.kicad_pcb, luma_cpu_v4.kicad_sch]
2024-12-22 updated BOM to make sense
    [bom.csv]
2024-12-22 added some capacitors to various components that weren't capacitored enough
    [Sheet_Power.kicad_sch, Sheet_USB.kicad_sch, luma_cpu_v4.kicad_pcb]
2024-12-23 fixed some silkscreen thickness issues
    [luma_cpu_v4.kicad_pcb]
